agustinmartino/wsjt_transceiver/(commit log)

2019-12-28 Switch relay 1second before the transmission starts
2020-12-23 Add several improvements for transceiver power stage an control
2021-02-25 Add files via upload
    Add schematic for power amplifier
2021-02-25 Add files via upload
    Re upload schematic
